Myzhar/RoboDiscovery-F4/README.md

RoboDiscovery-F4
================

Everything you need to create RoboDiscovery-F4
