Myzhar/RoboDiscovery-F4/Firmware/Sonar-Module.jpg

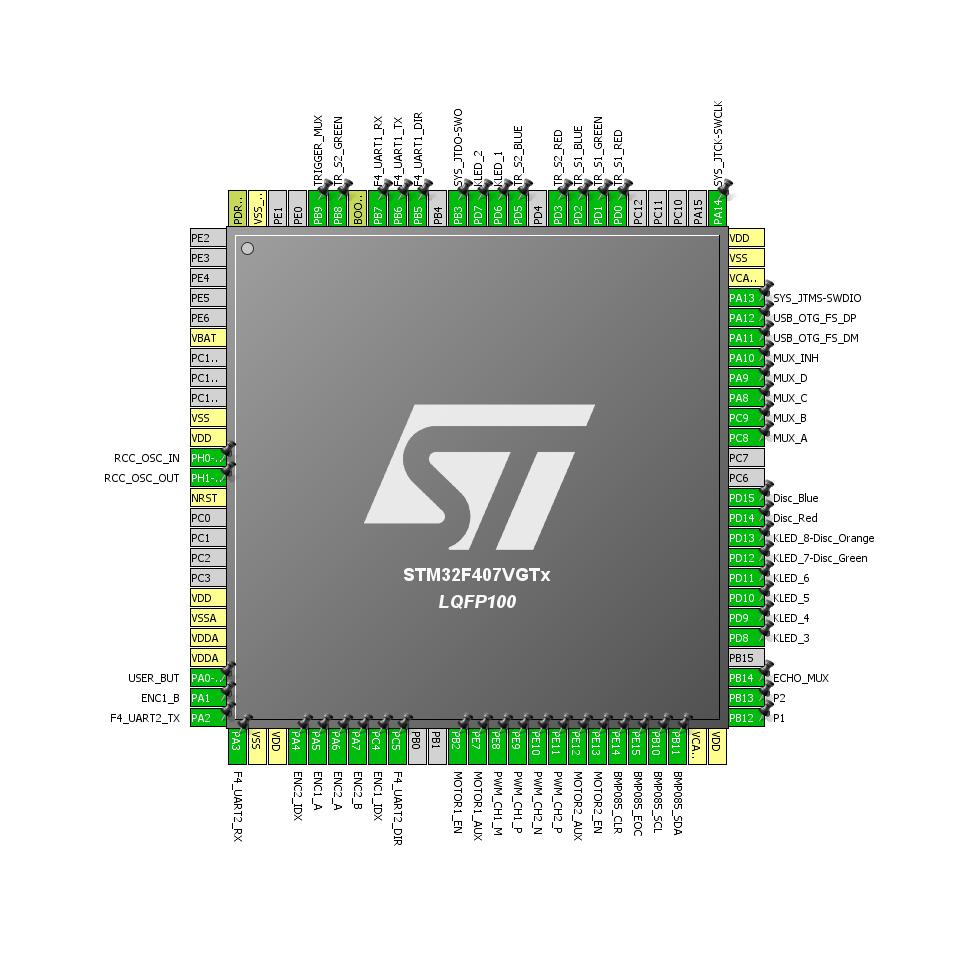
Firmware/Sonar-Module.jpg
