Myzhar/RoboDiscovery-F4/Board/RoboDiscovery-F4_v1.0/RoboDiscovery-F4_V1.0.pdf

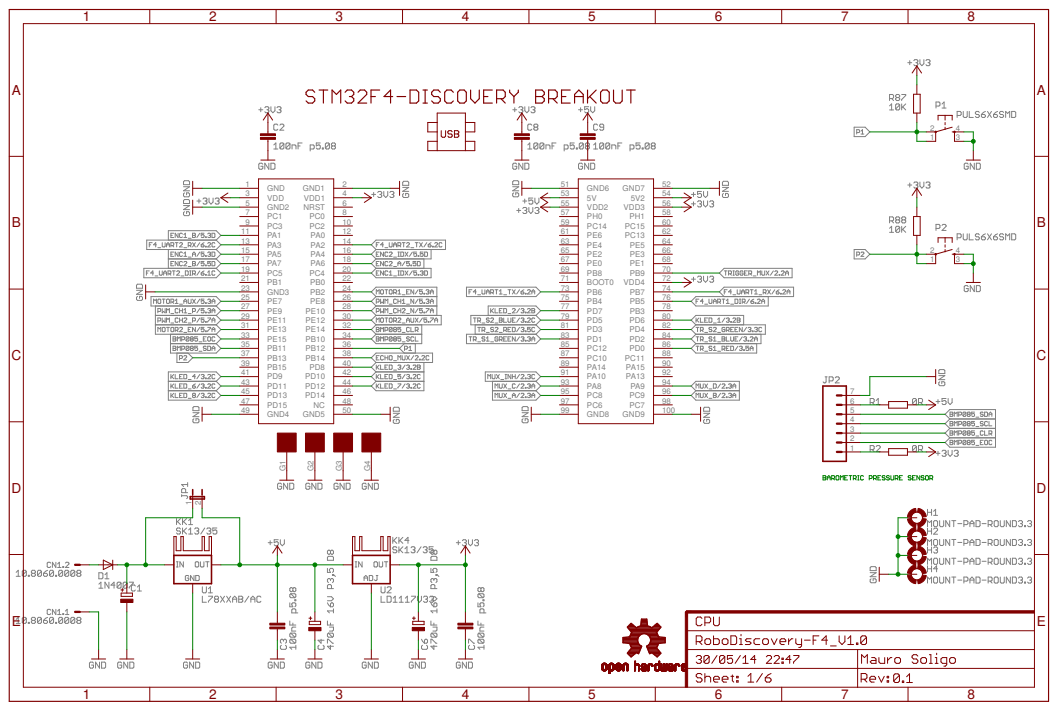
[picture p3: page 1]

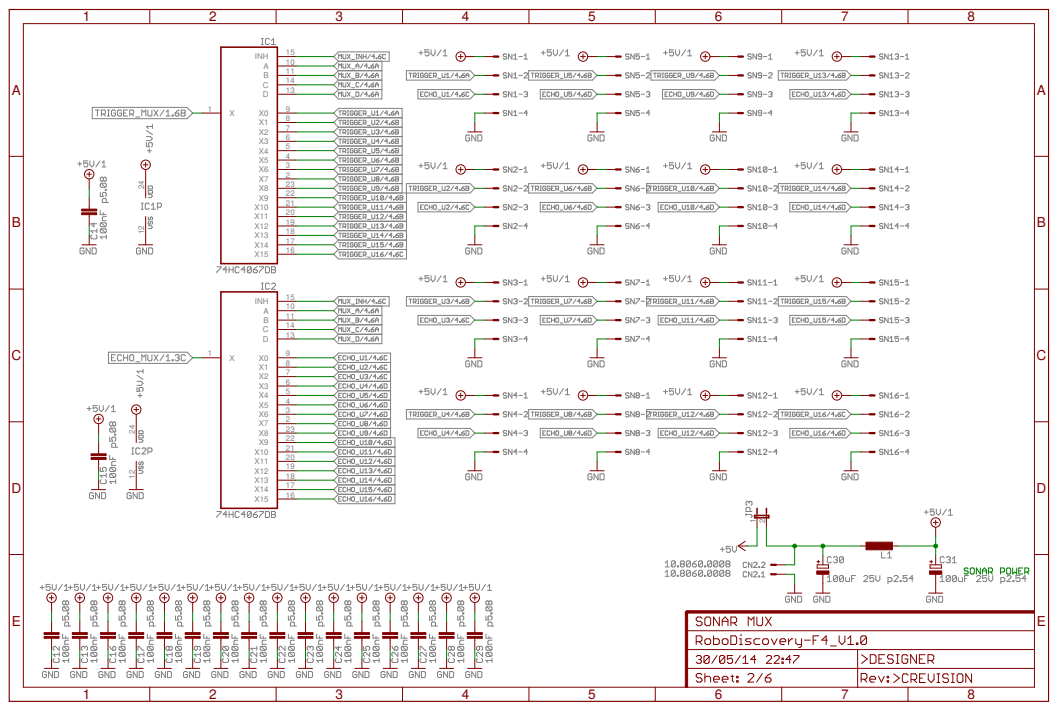
[picture p4: page 2]

12 A 10 B 11 C 14 D 13 X0 9 X1 8 X2 7 X3 6 X4 5 X5 4 X6 3 X7 2 X8 23 X9 22 X10 21 X11 20 X12 19 X13 18 X14 17 X15 16 X 1 INH 15 A 10 B 11 C 14 D 13 X0 9 X1 8 X2 7 X3 6 X4 5 X5 4 X6 3 X7 2 X8 23 X9 22 X10 21 X11 20 X12 19 X13 18 X14 17 X15 16 X 1 INH 15 12 24 12 24 ABCDE 1 2 3 4 5 6 7 8 ABCDE 1 2 3 4 5 6 7 8

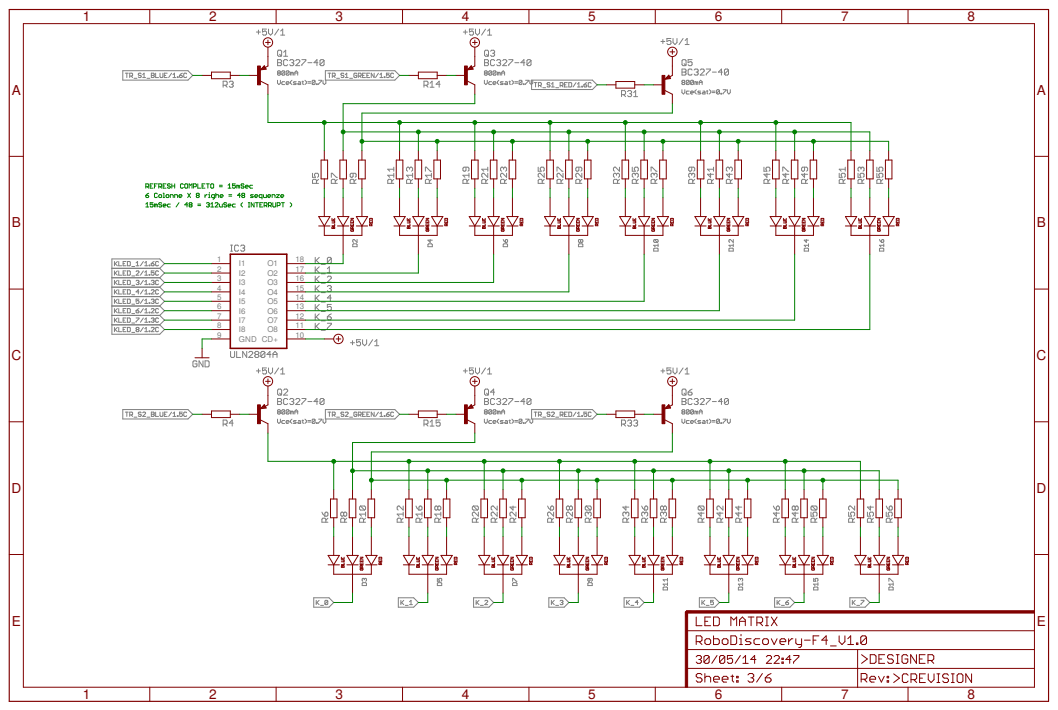
[picture p5: page 3]

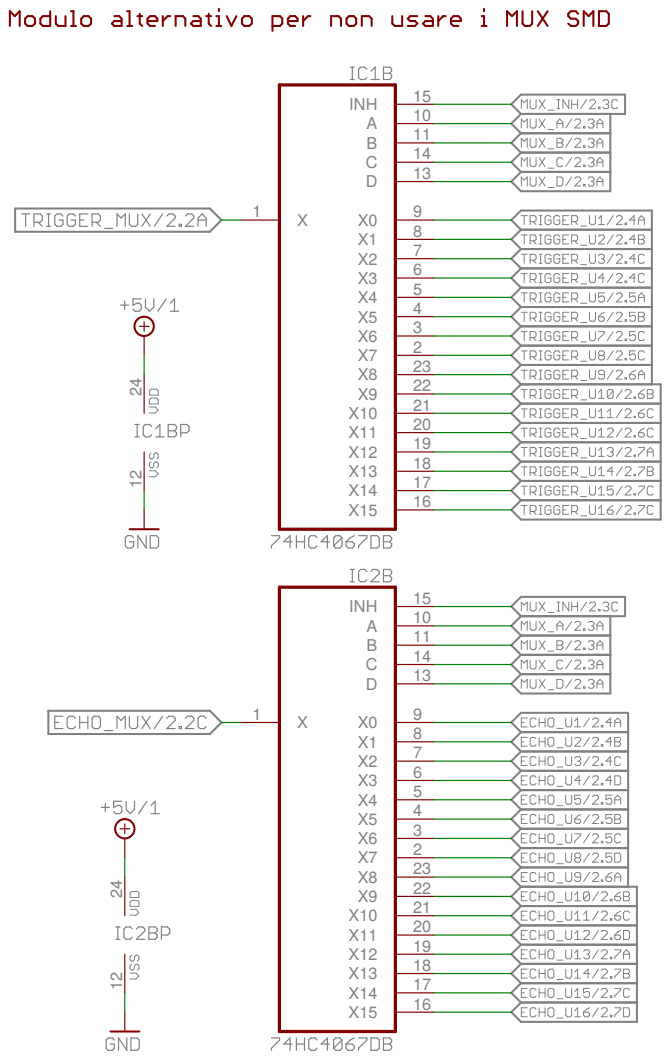
[picture p6: page 4]

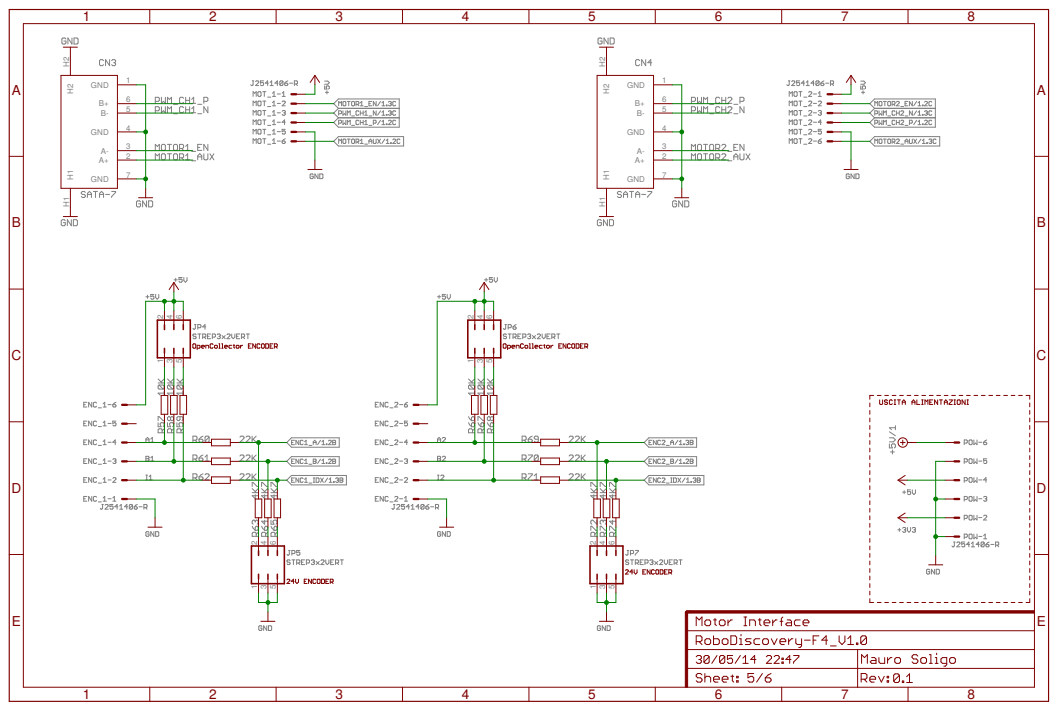
[picture p7: page 5]

1 2 3 4 5 6 1 2 3 4 5 6 H2 H2 B- 5 B+ 6 GND 1 GND 4 A- 3 A+ 2 GND H7 1 H1 H2 H2 B- 5 B+ 6 GND 1 GND 4 A- 3 A+ 2 GND H7 1 H1 1 2 3 4 5 6 1 2 3 4 5 6 ABCDE 1 2 3 4 5 6 7 8 ABCDE 1 2 3 4 5 6 7 8

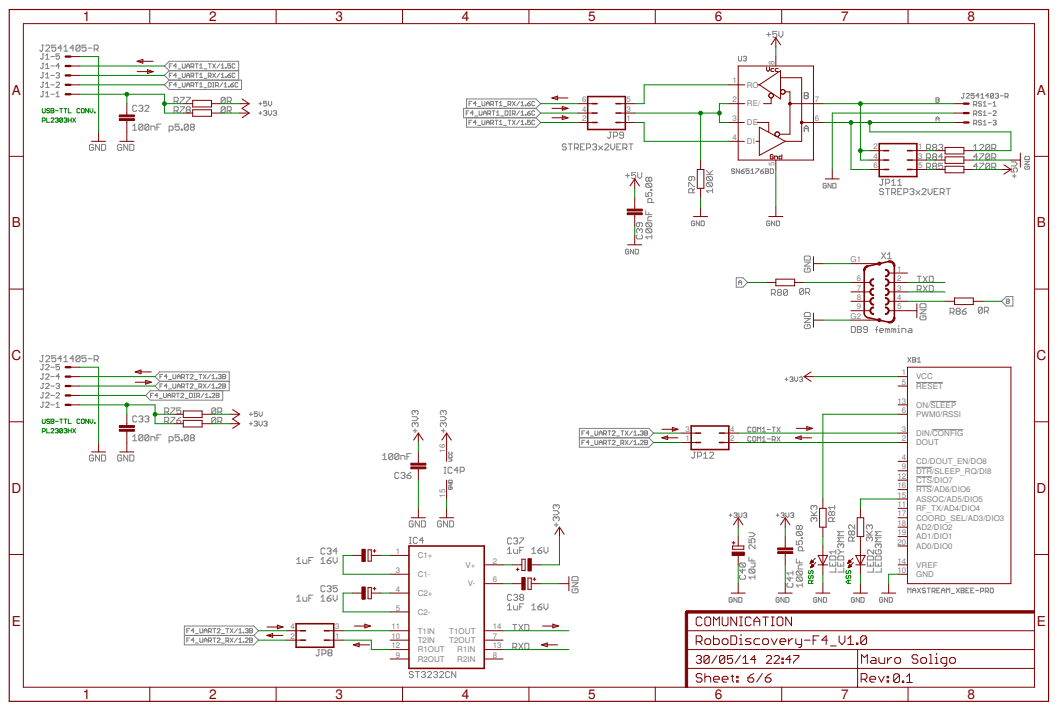
[picture p8: page 6]
