Myzhar/RoboDiscovery-F4/Board/RoboDiscovery-F4_v1.0/RoboDiscovery-F4_V1.0.brd

## EAGLE design Board/RoboDiscovery-F4_v1.0/RoboDiscovery-F4_V1.0.brd (2014-06-24)

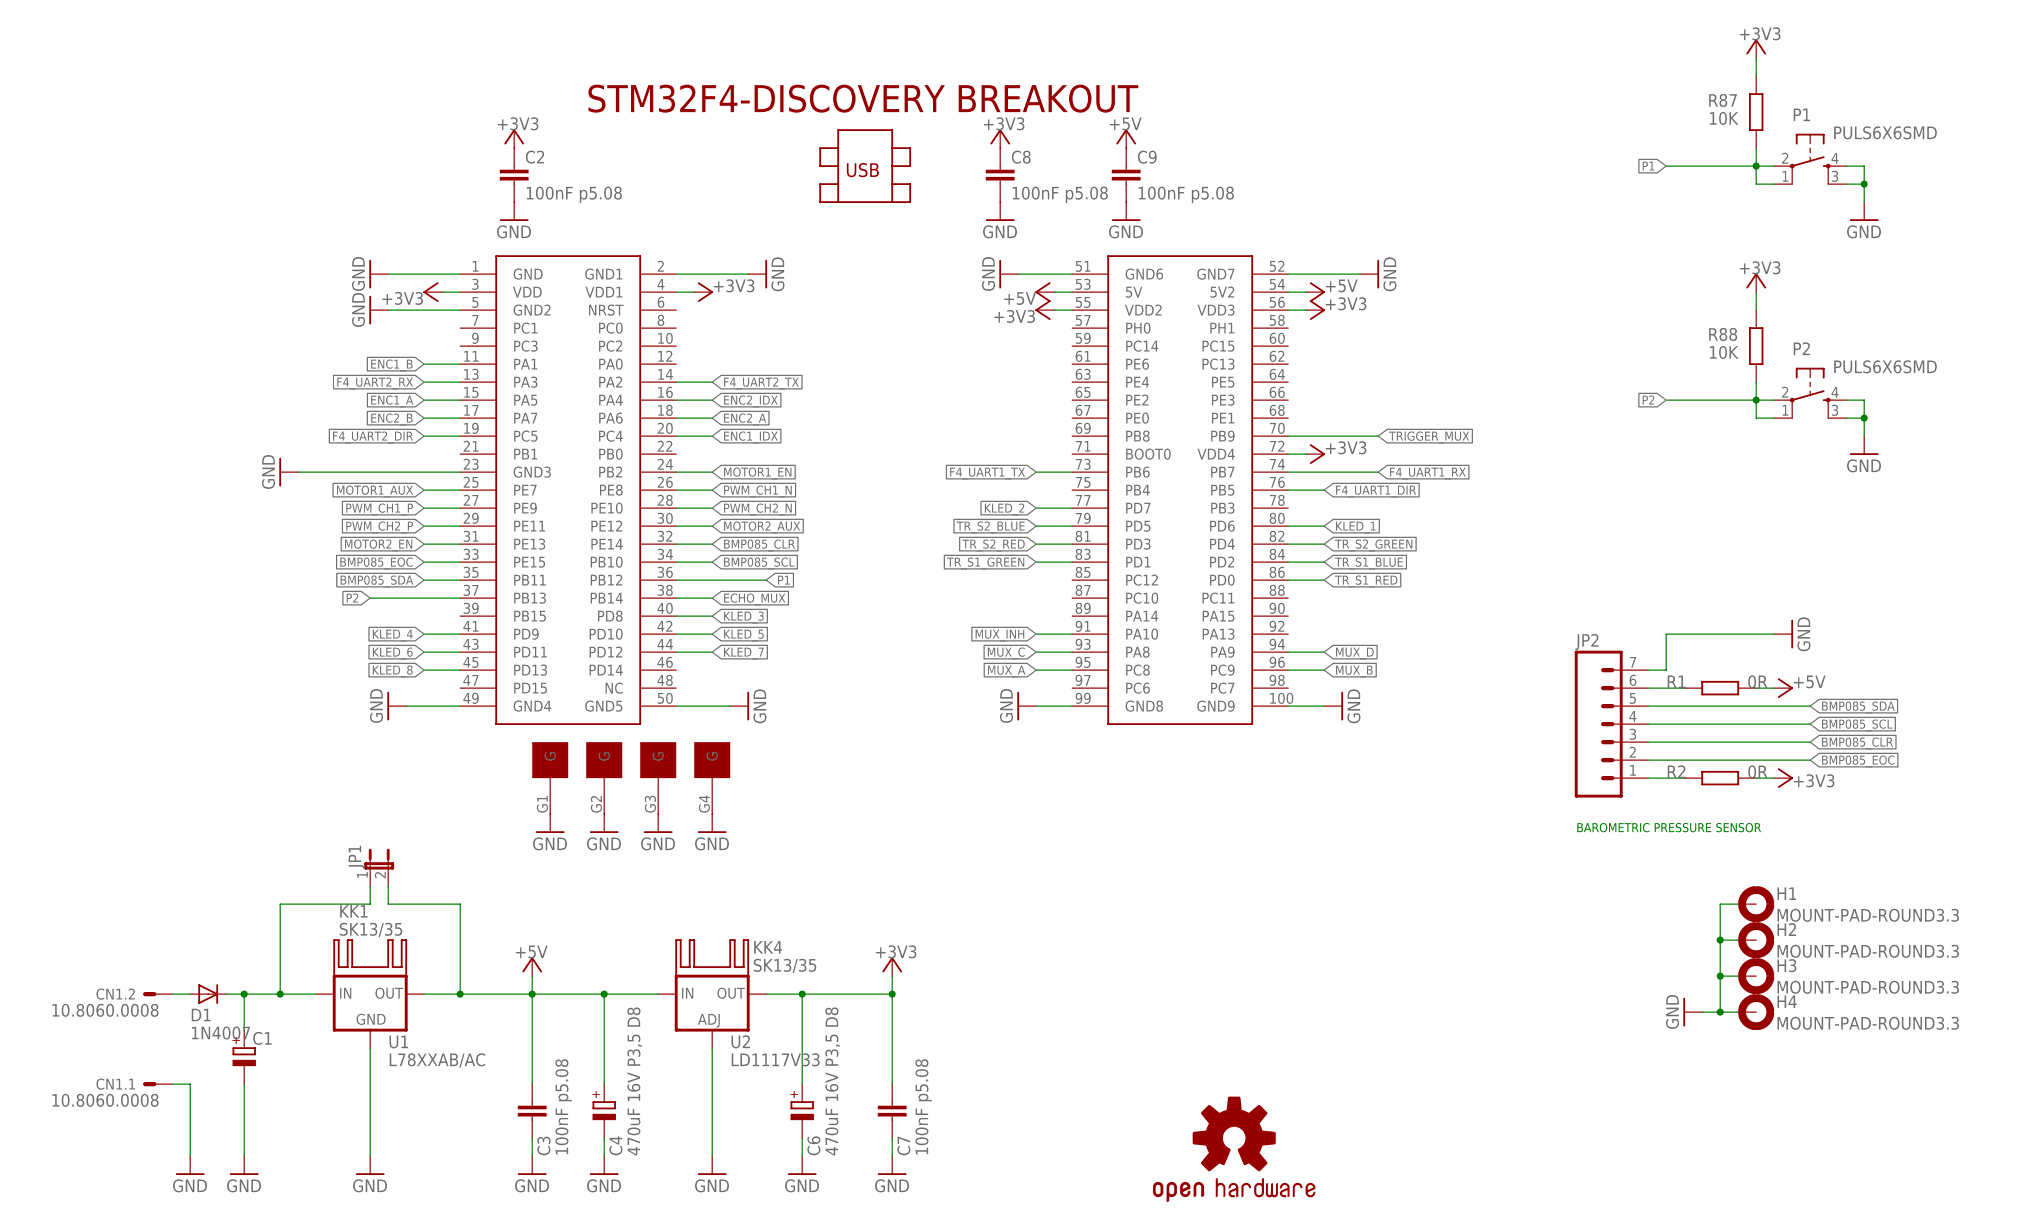
[picture p9: schematic RoboDiscovery-F4_V1.0.sch, sheet 1]

Parts:
C1: CPOL-EUE5-13; E5-13
C2, C3, C7, C8, C9: 100nF p5.08; C050-024X044
C4, C6: 470uF 16V P3,5 D8; E3,5-8
CN1: 10.8060.0008; 300-021-13_2P/5VE
D1: 1N4007; D041-10
DIS1: STM32F4-DISCOVERY
H1, H2, H3, H4: MOUNT-PAD-ROUND3.3; 3,3-PAD
JP1: JP1E; JP1
JP2: M07LONGPADS; 1X07_LONGPADS
KK1, KK4: SK13/35
LOGO1: OSHW-LOGOM; OSHW-LOGO-M
P1, P2: PULS6X6SMD
R1, R2: 0R; 0207/7
R87, R88: 10K; 0207/7
U1: L78XXAB/AC; 78XXL
U2: LD1117V33; 317TL

Connections:
+3V3: C2.1, C6.+, C7.1, C8.1, DIS1.3 (VDD), DIS1.4 (VDD1), DIS1.55 (VDD2), DIS1.56 (VDD3), DIS1.72 (VDD4), R2.1, R87.1, R88.1, U2.2 (OUT); also elsewhere on the board
+5V: C3.1, C4.+, C9.1, DIS1.53 (5V), DIS1.54 (5V2), JP1.2, R1.1, U1.OUT, U2.3 (IN); also elsewhere on the board
BMP085_CLR: DIS1.32 (PE14), JP2.3
BMP085_EOC: DIS1.33 (PE15), JP2.2
BMP085_SCL: DIS1.34 (PB10), JP2.4
BMP085_SDA: DIS1.35 (PB11), JP2.5
ECHO_MUX: DIS1.38 (PB14); also elsewhere on the board
ENC1_A: DIS1.15 (PA5); also elsewhere on the board
ENC1_B: DIS1.11 (PA1); also elsewhere on the board
ENC1_IDX: DIS1.20 (PC4); also elsewhere on the board
ENC2_A: DIS1.18 (PA6); also elsewhere on the board
ENC2_B: DIS1.17 (PA7); also elsewhere on the board
ENC2_IDX: DIS1.16 (PA4); also elsewhere on the board
F4_UART1_DIR: DIS1.76 (PB5); also elsewhere on the board
F4_UART1_RX: DIS1.74 (PB7); also elsewhere on the board
F4_UART1_TX: DIS1.73 (PB6); also elsewhere on the board
F4_UART2_DIR: DIS1.19 (PC5); also elsewhere on the board
F4_UART2_RX: DIS1.13 (PA3); also elsewhere on the board
F4_UART2_TX: DIS1.14 (PA2); also elsewhere on the board
GND: C1.-, C2.2, C3.2, C4.-, C6.-, C7.2, C8.2, C9.2, CN1.1, DIS1.1 (GND), DIS1.2 (GND1), DIS1.5 (GND2), DIS1.23 (GND3), DIS1.49 (GND4), DIS1.50 (GND5), DIS1.51 (GND6), DIS1.52 (GND7), DIS1.99 (GND8), DIS1.100 (GND9), DIS1.G1 (G), DIS1.G2 (G), DIS1.G3 (G), DIS1.G4 (G), H1.B3,3, H2.B3,3, H3.B3,3, H4.B3,3, JP2.7, P1.3 (S1), P1.4 (S), P2.3 (S1), P2.4 (S), U1.GND, U2.1 (ADJ); also elsewhere on the board
KLED_1: DIS1.80 (PD6); also elsewhere on the board
KLED_2: DIS1.77 (PD7); also elsewhere on the board
KLED_3: DIS1.40 (PD8); also elsewhere on the board
KLED_4: DIS1.41 (PD9); also elsewhere on the board
KLED_5: DIS1.42 (PD10); also elsewhere on the board
KLED_6: DIS1.43 (PD11); also elsewhere on the board
KLED_7: DIS1.44 (PD12); also elsewhere on the board
KLED_8: DIS1.45 (PD13); also elsewhere on the board
MOTOR1_AUX: DIS1.25 (PE7); also elsewhere on the board
MOTOR1_EN: DIS1.24 (PB2); also elsewhere on the board
MOTOR2_AUX: DIS1.30 (PE12); also elsewhere on the board
MOTOR2_EN: DIS1.31 (PE13); also elsewhere on the board
MUX_A: DIS1.95 (PC8); also elsewhere on the board
MUX_B: DIS1.96 (PC9); also elsewhere on the board
MUX_C: DIS1.93 (PA8); also elsewhere on the board
MUX_D: DIS1.94 (PA9); also elsewhere on the board
MUX_INH: DIS1.91 (PA10); also elsewhere on the board
unnamed: C1.+, D1.C, JP1.1, U1.IN
unnamed: JP2.6, R1.2
unnamed: JP2.1, R2.2
unnamed: CN1.2, D1.A
P1: DIS1.36 (PB12), P1.1, P1.2, R87.2
P2: DIS1.37 (PB13), P2.1, P2.2, R88.2
PWM_CH1_N: DIS1.26 (PE8); also elsewhere on the board
PWM_CH1_P: DIS1.27 (PE9); also elsewhere on the board
PWM_CH2_N: DIS1.28 (PE10); also elsewhere on the board
PWM_CH2_P: DIS1.29 (PE11); also elsewhere on the board
TRIGGER_MUX: DIS1.70 (PB9); also elsewhere on the board
TR_S1_BLUE: DIS1.84 (PD2); also elsewhere on the board
TR_S1_GREEN: DIS1.83 (PD1); also elsewhere on the board
TR_S1_RED: DIS1.86 (PD0); also elsewhere on the board
TR_S2_BLUE: DIS1.79 (PD5); also elsewhere on the board
TR_S2_GREEN: DIS1.82 (PD4); also elsewhere on the board
TR_S2_RED: DIS1.81 (PD3); also elsewhere on the board

Notes on the sheet:
BAROMETRIC PRESSURE SENSOR

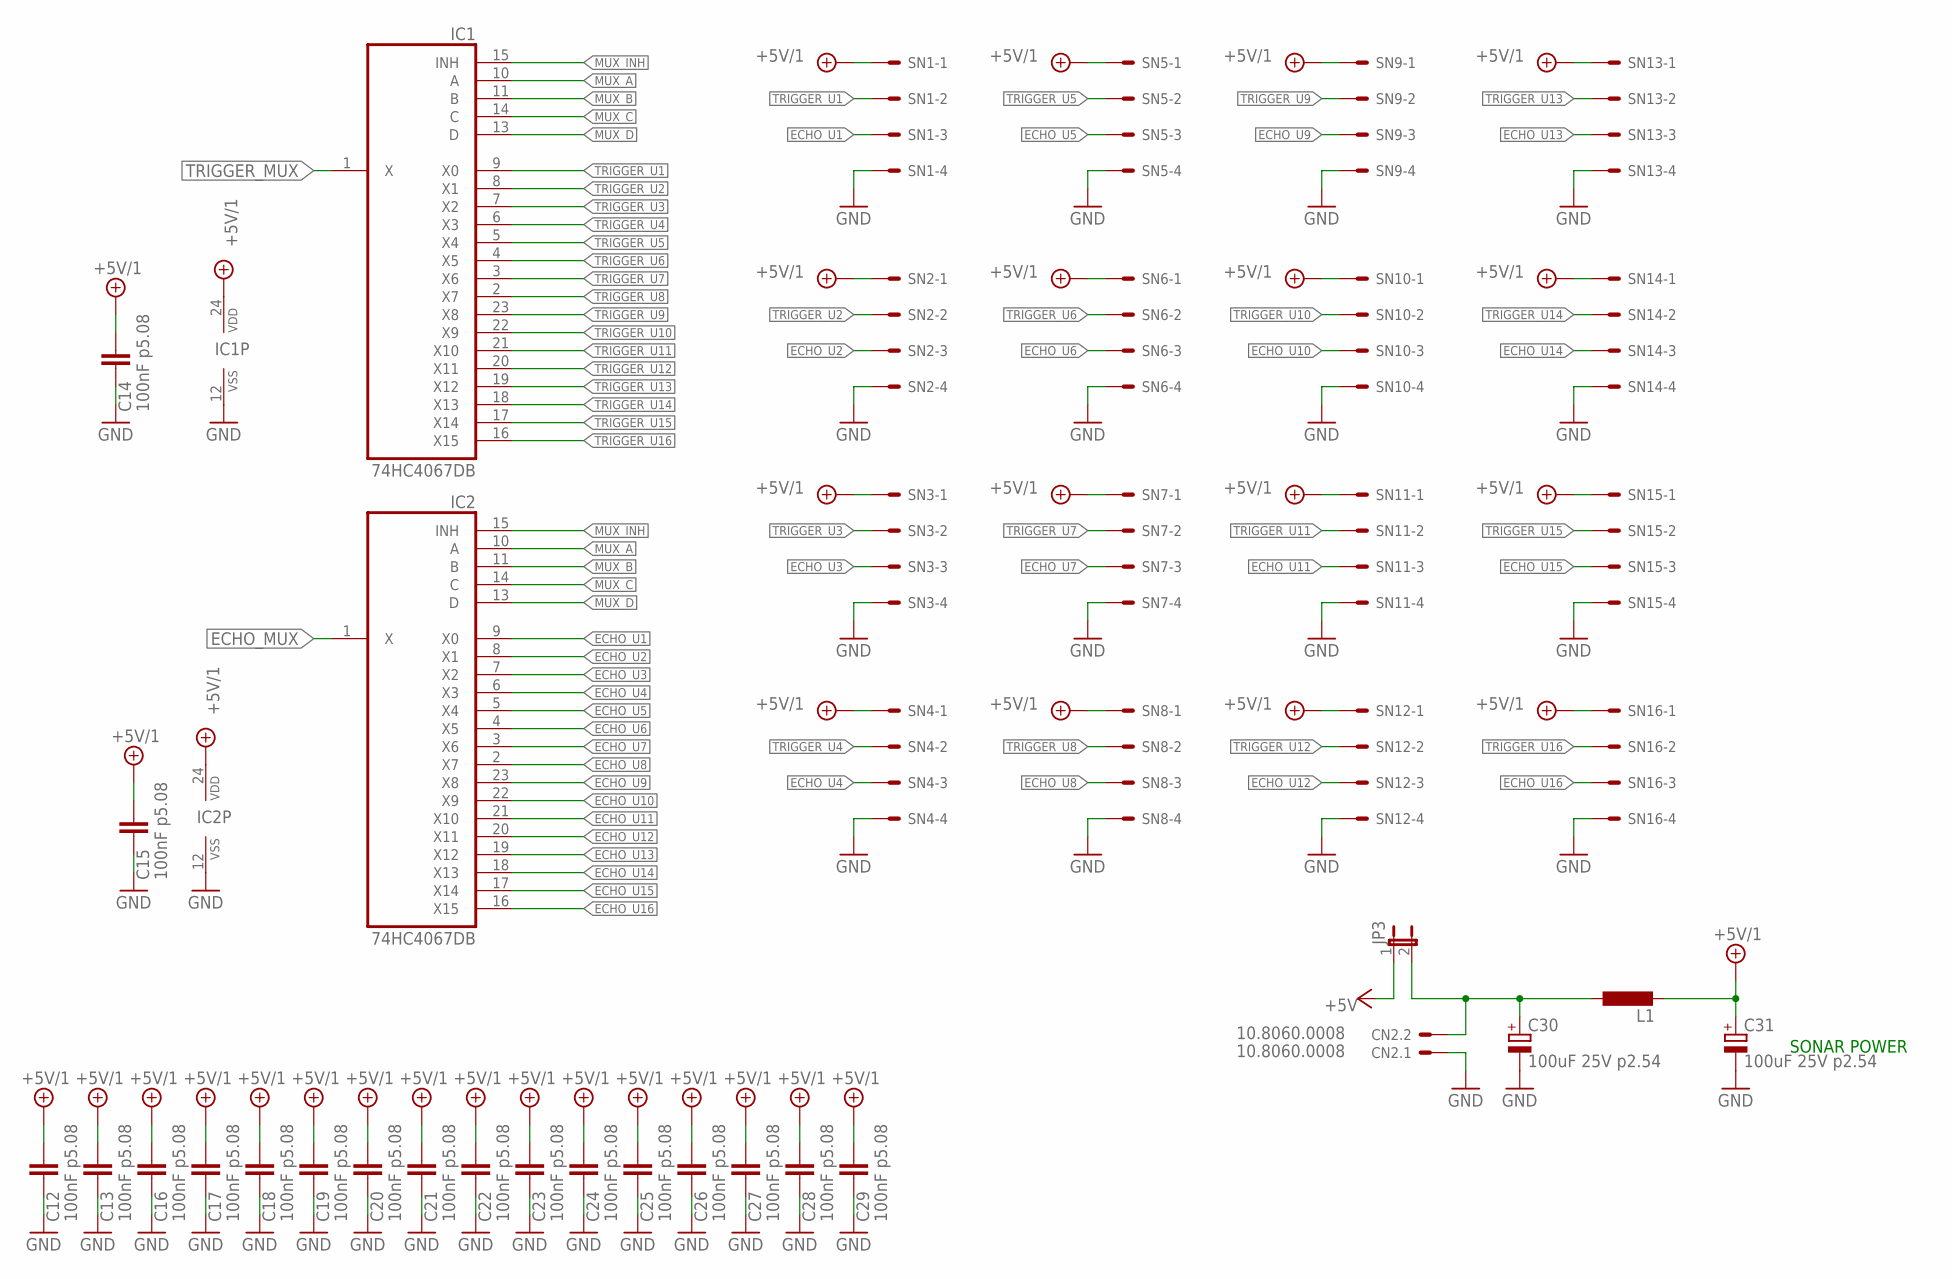
[picture p10: schematic RoboDiscovery-F4_V1.0.sch, sheet 2]

Parts:
C12, C13, C14, C15, C16, C17, C18, C19, C20, C21, C22, C23, C24, C25, C26, C27, C28, C29: 100nF p5.08; C050-024X044
C30, C31: 100uF 25V p2.54; E2,5-6
CN2: 10.8060.0008; 300-021-13_2P/5VE
IC1, IC2: 74HC4067DB; SO24W
JP3: JP1E; JP1
L1: L-EU2200-12.7; 2200-12.7
SN1, SN2, SN3, SN4, SN5, SN6, SN7, SN8, SN9, SN10, SN11, SN12, SN13, SN14, SN15, SN16: 22-27-2041-04; 6410-04

Connections:
+5V: JP3.1; also elsewhere on the board
+5V/1: C12.1, C13.1, C14.1, C15.1, C16.1, C17.1, C18.1, C19.1, C20.1, C21.1, C22.1, C23.1, C24.1, C25.1, C26.1, C27.1, C28.1, C29.1, C31.+, IC1.24 (VDD), IC2.24 (VDD), L1.2, SN1.1, SN2.1, SN3.1, SN4.1, SN5.1, SN6.1, SN7.1, SN8.1, SN9.1, SN10.1, SN11.1, SN12.1, SN13.1, SN14.1, SN15.1, SN16.1; also elsewhere on the board
ECHO_MUX: IC2.1 (X); also elsewhere on the board
ECHO_U1: IC2.9 (X0), SN1.3; also elsewhere on the board
ECHO_U2: IC2.8 (X1), SN2.3; also elsewhere on the board
ECHO_U3: IC2.7 (X2), SN3.3; also elsewhere on the board
ECHO_U4: IC2.6 (X3), SN4.3; also elsewhere on the board
ECHO_U5: IC2.5 (X4), SN5.3; also elsewhere on the board
ECHO_U6: IC2.4 (X5), SN6.3; also elsewhere on the board
ECHO_U7: IC2.3 (X6), SN7.3; also elsewhere on the board
ECHO_U8: IC2.2 (X7), SN8.3; also elsewhere on the board
ECHO_U9: IC2.23 (X8), SN9.3; also elsewhere on the board
ECHO_U10: IC2.22 (X9), SN10.3; also elsewhere on the board
ECHO_U11: IC2.21 (X10), SN11.3; also elsewhere on the board
ECHO_U12: IC2.20 (X11), SN12.3; also elsewhere on the board
ECHO_U13: IC2.19 (X12), SN13.3; also elsewhere on the board
ECHO_U14: IC2.18 (X13), SN14.3; also elsewhere on the board
ECHO_U15: IC2.17 (X14), SN15.3; also elsewhere on the board
ECHO_U16: IC2.16 (X15), SN16.3; also elsewhere on the board
GND: C12.2, C13.2, C14.2, C15.2, C16.2, C17.2, C18.2, C19.2, C20.2, C21.2, C22.2, C23.2, C24.2, C25.2, C26.2, C27.2, C28.2, C29.2, C30.-, C31.-, CN2.1, IC1.12 (VSS), IC2.12 (VSS), SN1.4, SN2.4, SN3.4, SN4.4, SN5.4, SN6.4, SN7.4, SN8.4, SN9.4, SN10.4, SN11.4, SN12.4, SN13.4, SN14.4, SN15.4, SN16.4; also elsewhere on the board
MUX_A: IC1.10 (A), IC2.10 (A); also elsewhere on the board
MUX_B: IC1.11 (B), IC2.11 (B); also elsewhere on the board
MUX_C: IC1.14 (C), IC2.14 (C); also elsewhere on the board
MUX_D: IC1.13 (D), IC2.13 (D); also elsewhere on the board
MUX_INH: IC1.15 (INH), IC2.15 (INH); also elsewhere on the board
unnamed: C30.+, CN2.2, JP3.2, L1.1
TRIGGER_MUX: IC1.1 (X); also elsewhere on the board
TRIGGER_U1: IC1.9 (X0), SN1.2; also elsewhere on the board
TRIGGER_U2: IC1.8 (X1), SN2.2; also elsewhere on the board
TRIGGER_U3: IC1.7 (X2), SN3.2; also elsewhere on the board
TRIGGER_U4: IC1.6 (X3), SN4.2; also elsewhere on the board
TRIGGER_U5: IC1.5 (X4), SN5.2; also elsewhere on the board
TRIGGER_U6: IC1.4 (X5), SN6.2; also elsewhere on the board
TRIGGER_U7: IC1.3 (X6), SN7.2; also elsewhere on the board
TRIGGER_U8: IC1.2 (X7), SN8.2; also elsewhere on the board
TRIGGER_U9: IC1.23 (X8), SN9.2; also elsewhere on the board
TRIGGER_U10: IC1.22 (X9), SN10.2; also elsewhere on the board
TRIGGER_U11: IC1.21 (X10), SN11.2; also elsewhere on the board
TRIGGER_U12: IC1.20 (X11), SN12.2; also elsewhere on the board
TRIGGER_U13: IC1.19 (X12), SN13.2; also elsewhere on the board
TRIGGER_U14: IC1.18 (X13), SN14.2; also elsewhere on the board
TRIGGER_U15: IC1.17 (X14), SN15.2; also elsewhere on the board
TRIGGER_U16: IC1.16 (X15), SN16.2; also elsewhere on the board

Notes on the sheet:
SONAR POWER

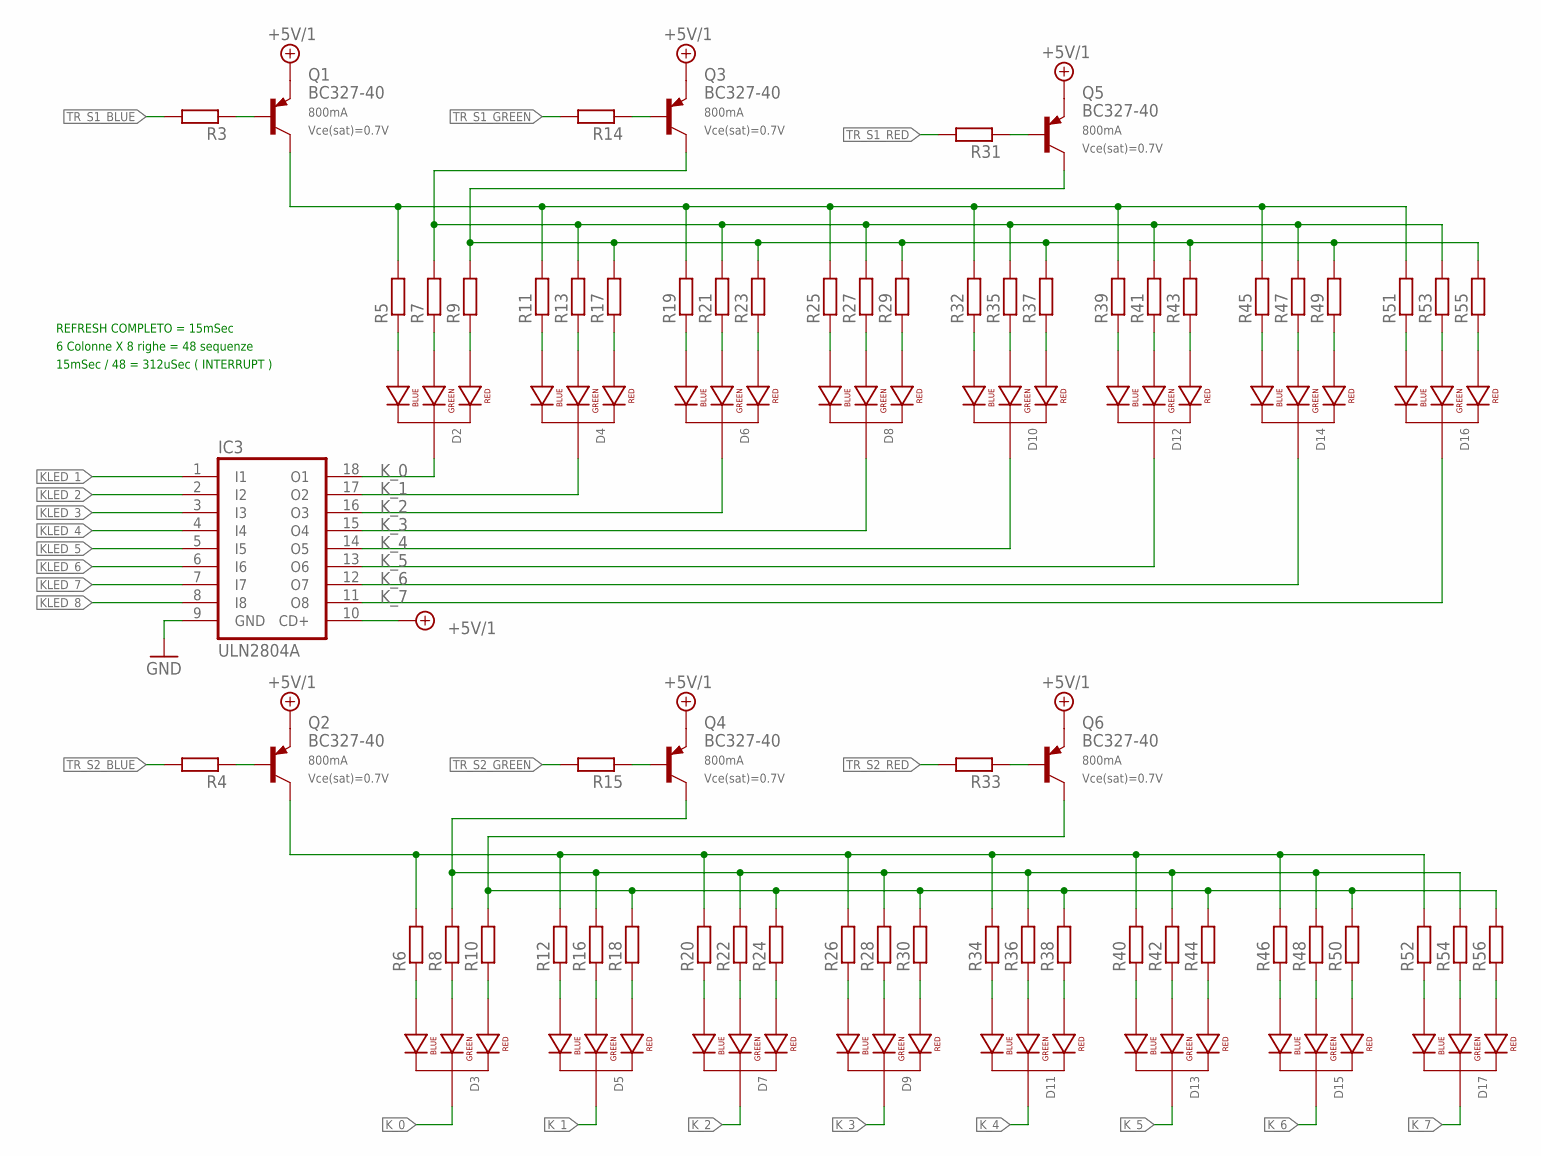
[picture p11: schematic RoboDiscovery-F4_V1.0.sch, sheet 3]

Parts:
D2, D3, D4, D5, D6, D7, D8, D9, D10, D11, D12, D13, D14, D15, D16, D17: LED-RGB-CC-THRUDIFFUSE; LED-RGB-THRU
IC3: ULN2804A; DIL18
Q1, Q2, Q3, Q4, Q5, Q6: BC327-40; TO92-EBC
R3, R4, R5, R6, R7, R8, R9, R10, R11, R12, R13, R14, R15, R16, R17, R18, R19, R20, R21, R22, R23, R24, R25, R26, R27, R28, R29, R30, R31, R32, R33, R34, R35, R36, R37, R38, R39, R40, R41, R42, R43, R44, R45, R46, R47, R48, R49, R50, R51, R52, R53, R54, R55, R56: R-EU_0207/7; 0207/7

Connections:
+5V/1: IC3.10 (CD+), Q1.E, Q2.E, Q3.E, Q4.E, Q5.E, Q6.E; also elsewhere on the board
GND: IC3.9 (GND); also elsewhere on the board
KLED_1: IC3.1 (I1); also elsewhere on the board
KLED_2: IC3.2 (I2); also elsewhere on the board
KLED_3: IC3.3 (I3); also elsewhere on the board
KLED_4: IC3.4 (I4); also elsewhere on the board
KLED_5: IC3.5 (I5); also elsewhere on the board
KLED_6: IC3.6 (I6); also elsewhere on the board
KLED_7: IC3.7 (I7); also elsewhere on the board
KLED_8: IC3.8 (I8); also elsewhere on the board
K_0: D2.2 (CATHODE), D3.2 (CATHODE), IC3.18 (O1)
K_1: D4.2 (CATHODE), D5.2 (CATHODE), IC3.17 (O2)
K_2: D6.2 (CATHODE), D7.2 (CATHODE), IC3.16 (O3)
K_3: D8.2 (CATHODE), D9.2 (CATHODE), IC3.15 (O4)
K_4: D10.2 (CATHODE), D11.2 (CATHODE), IC3.14 (O5)
K_5: D12.2 (CATHODE), D13.2 (CATHODE), IC3.13 (O6)
K_6: D14.2 (CATHODE), D15.2 (CATHODE), IC3.12 (O7)
K_7: D16.2 (CATHODE), D17.2 (CATHODE), IC3.11 (O8)
unnamed: Q1.C, R5.2, R11.2, R19.2, R25.2, R32.2, R39.2, R45.2, R51.2
unnamed: Q3.C, R7.2, R13.2, R21.2, R27.2, R35.2, R41.2, R47.2, R53.2
unnamed: Q5.C, R9.2, R17.2, R23.2, R29.2, R37.2, R43.2, R49.2, R55.2
unnamed: D2.4 (BLUE_CATHODE), R5.1
unnamed: D2.3 (GREEN_CATHODE), R7.1
unnamed: D2.1 (RED_CATHODE), R9.1
unnamed: D4.4 (BLUE_CATHODE), R11.1
unnamed: D4.3 (GREEN_CATHODE), R13.1
unnamed: D4.1 (RED_CATHODE), R17.1
unnamed: D6.4 (BLUE_CATHODE), R19.1
unnamed: D6.3 (GREEN_CATHODE), R21.1
unnamed: D6.1 (RED_CATHODE), R23.1
unnamed: D8.4 (BLUE_CATHODE), R25.1
unnamed: D8.3 (GREEN_CATHODE), R27.1
unnamed: D8.1 (RED_CATHODE), R29.1
unnamed: D10.4 (BLUE_CATHODE), R32.1
unnamed: D10.3 (GREEN_CATHODE), R35.1
unnamed: D10.1 (RED_CATHODE), R37.1
unnamed: D12.4 (BLUE_CATHODE), R39.1
unnamed: D12.3 (GREEN_CATHODE), R41.1
unnamed: D12.1 (RED_CATHODE), R43.1
unnamed: D14.4 (BLUE_CATHODE), R45.1
unnamed: D14.3 (GREEN_CATHODE), R47.1
unnamed: D14.1 (RED_CATHODE), R49.1
unnamed: D16.4 (BLUE_CATHODE), R51.1
unnamed: D16.3 (GREEN_CATHODE), R53.1
unnamed: D16.1 (RED_CATHODE), R55.1
unnamed: Q2.C, R6.2, R12.2, R20.2, R26.2, R34.2, R40.2, R46.2, R52.2
unnamed: Q4.C, R8.2, R16.2, R22.2, R28.2, R36.2, R42.2, R48.2, R54.2
unnamed: Q6.C, R10.2, R18.2, R24.2, R30.2, R38.2, R44.2, R50.2, R56.2
unnamed: D3.4 (BLUE_CATHODE), R6.1
unnamed: D3.3 (GREEN_CATHODE), R8.1
unnamed: D3.1 (RED_CATHODE), R10.1
unnamed: D5.4 (BLUE_CATHODE), R12.1
unnamed: D5.3 (GREEN_CATHODE), R16.1
unnamed: D5.1 (RED_CATHODE), R18.1
unnamed: D7.4 (BLUE_CATHODE), R20.1
unnamed: D7.3 (GREEN_CATHODE), R22.1
unnamed: D7.1 (RED_CATHODE), R24.1
unnamed: D9.4 (BLUE_CATHODE), R26.1
unnamed: D9.3 (GREEN_CATHODE), R28.1
unnamed: D9.1 (RED_CATHODE), R30.1
unnamed: D11.4 (BLUE_CATHODE), R34.1
unnamed: D11.3 (GREEN_CATHODE), R36.1
unnamed: D11.1 (RED_CATHODE), R38.1
unnamed: D13.4 (BLUE_CATHODE), R40.1
unnamed: D13.3 (GREEN_CATHODE), R42.1
unnamed: D13.1 (RED_CATHODE), R44.1
unnamed: D15.4 (BLUE_CATHODE), R46.1
unnamed: D15.3 (GREEN_CATHODE), R48.1
unnamed: D15.1 (RED_CATHODE), R50.1
unnamed: D17.4 (BLUE_CATHODE), R52.1
unnamed: D17.3 (GREEN_CATHODE), R54.1
unnamed: D17.1 (RED_CATHODE), R56.1
unnamed: Q1.B, R3.1
unnamed: Q3.B, R14.1
unnamed: Q5.B, R31.1
unnamed: Q2.B, R4.1
unnamed: Q4.B, R15.1
unnamed: Q6.B, R33.1
TR_S1_BLUE: R3.2; also elsewhere on the board
TR_S1_GREEN: R14.2; also elsewhere on the board
TR_S1_RED: R31.2; also elsewhere on the board
TR_S2_BLUE: R4.2; also elsewhere on the board
TR_S2_GREEN: R15.2; also elsewhere on the board
TR_S2_RED: R33.2; also elsewhere on the board

Notes on the sheet:
REFRESH COMPLETO = 15mSec
6 Colonne X 8 righe = 48 sequenze
15mSec / 48 = 312uSec ( INTERRUPT )

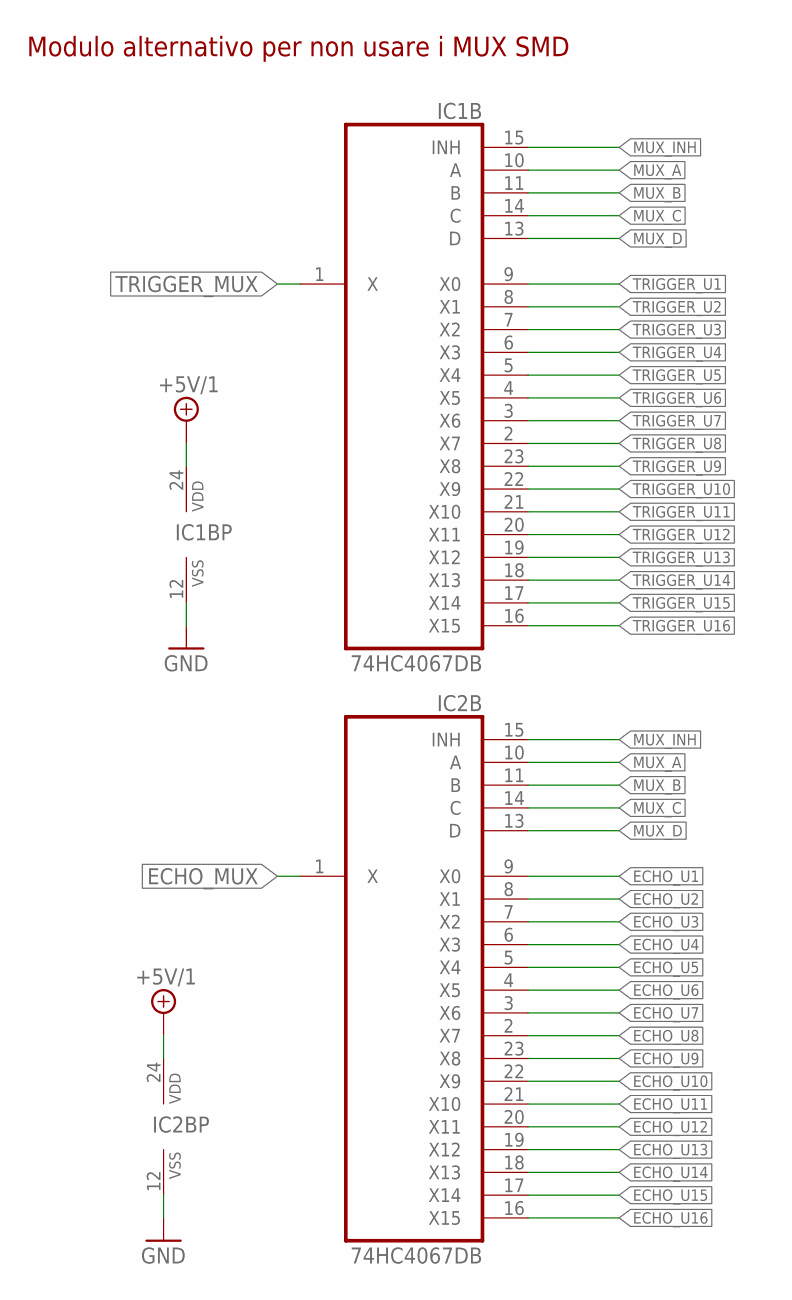
[picture p12: schematic RoboDiscovery-F4_V1.0.sch, sheet 4]

Parts:
IC1B, IC2B: 74HC4067DB; DIL24-6

Connections:
+5V/1: IC1B.24 (VDD), IC2B.24 (VDD); also elsewhere on the board
ECHO_MUX: IC2B.1 (X); also elsewhere on the board
ECHO_U1: IC2B.9 (X0); also elsewhere on the board
ECHO_U2: IC2B.8 (X1); also elsewhere on the board
ECHO_U3: IC2B.7 (X2); also elsewhere on the board
ECHO_U4: IC2B.6 (X3); also elsewhere on the board
ECHO_U5: IC2B.5 (X4); also elsewhere on the board
ECHO_U6: IC2B.4 (X5); also elsewhere on the board
ECHO_U7: IC2B.3 (X6); also elsewhere on the board
ECHO_U8: IC2B.2 (X7); also elsewhere on the board
ECHO_U9: IC2B.23 (X8); also elsewhere on the board
ECHO_U10: IC2B.22 (X9); also elsewhere on the board
ECHO_U11: IC2B.21 (X10); also elsewhere on the board
ECHO_U12: IC2B.20 (X11); also elsewhere on the board
ECHO_U13: IC2B.19 (X12); also elsewhere on the board
ECHO_U14: IC2B.18 (X13); also elsewhere on the board
ECHO_U15: IC2B.17 (X14); also elsewhere on the board
ECHO_U16: IC2B.16 (X15); also elsewhere on the board
GND: IC1B.12 (VSS), IC2B.12 (VSS); also elsewhere on the board
MUX_A: IC1B.10 (A), IC2B.10 (A); also elsewhere on the board
MUX_B: IC1B.11 (B), IC2B.11 (B); also elsewhere on the board
MUX_C: IC1B.14 (C), IC2B.14 (C); also elsewhere on the board
MUX_D: IC1B.13 (D), IC2B.13 (D); also elsewhere on the board
MUX_INH: IC1B.15 (INH), IC2B.15 (INH); also elsewhere on the board
TRIGGER_MUX: IC1B.1 (X); also elsewhere on the board
TRIGGER_U1: IC1B.9 (X0); also elsewhere on the board
TRIGGER_U2: IC1B.8 (X1); also elsewhere on the board
TRIGGER_U3: IC1B.7 (X2); also elsewhere on the board
TRIGGER_U4: IC1B.6 (X3); also elsewhere on the board
TRIGGER_U5: IC1B.5 (X4); also elsewhere on the board
TRIGGER_U6: IC1B.4 (X5); also elsewhere on the board
TRIGGER_U7: IC1B.3 (X6); also elsewhere on the board
TRIGGER_U8: IC1B.2 (X7); also elsewhere on the board
TRIGGER_U9: IC1B.23 (X8); also elsewhere on the board
TRIGGER_U10: IC1B.22 (X9); also elsewhere on the board
TRIGGER_U11: IC1B.21 (X10); also elsewhere on the board
TRIGGER_U12: IC1B.20 (X11); also elsewhere on the board
TRIGGER_U13: IC1B.19 (X12); also elsewhere on the board
TRIGGER_U14: IC1B.18 (X13); also elsewhere on the board
TRIGGER_U15: IC1B.17 (X14); also elsewhere on the board
TRIGGER_U16: IC1B.16 (X15); also elsewhere on the board

Notes on the sheet:
Modulo alternativo per non usare i MUX SMD

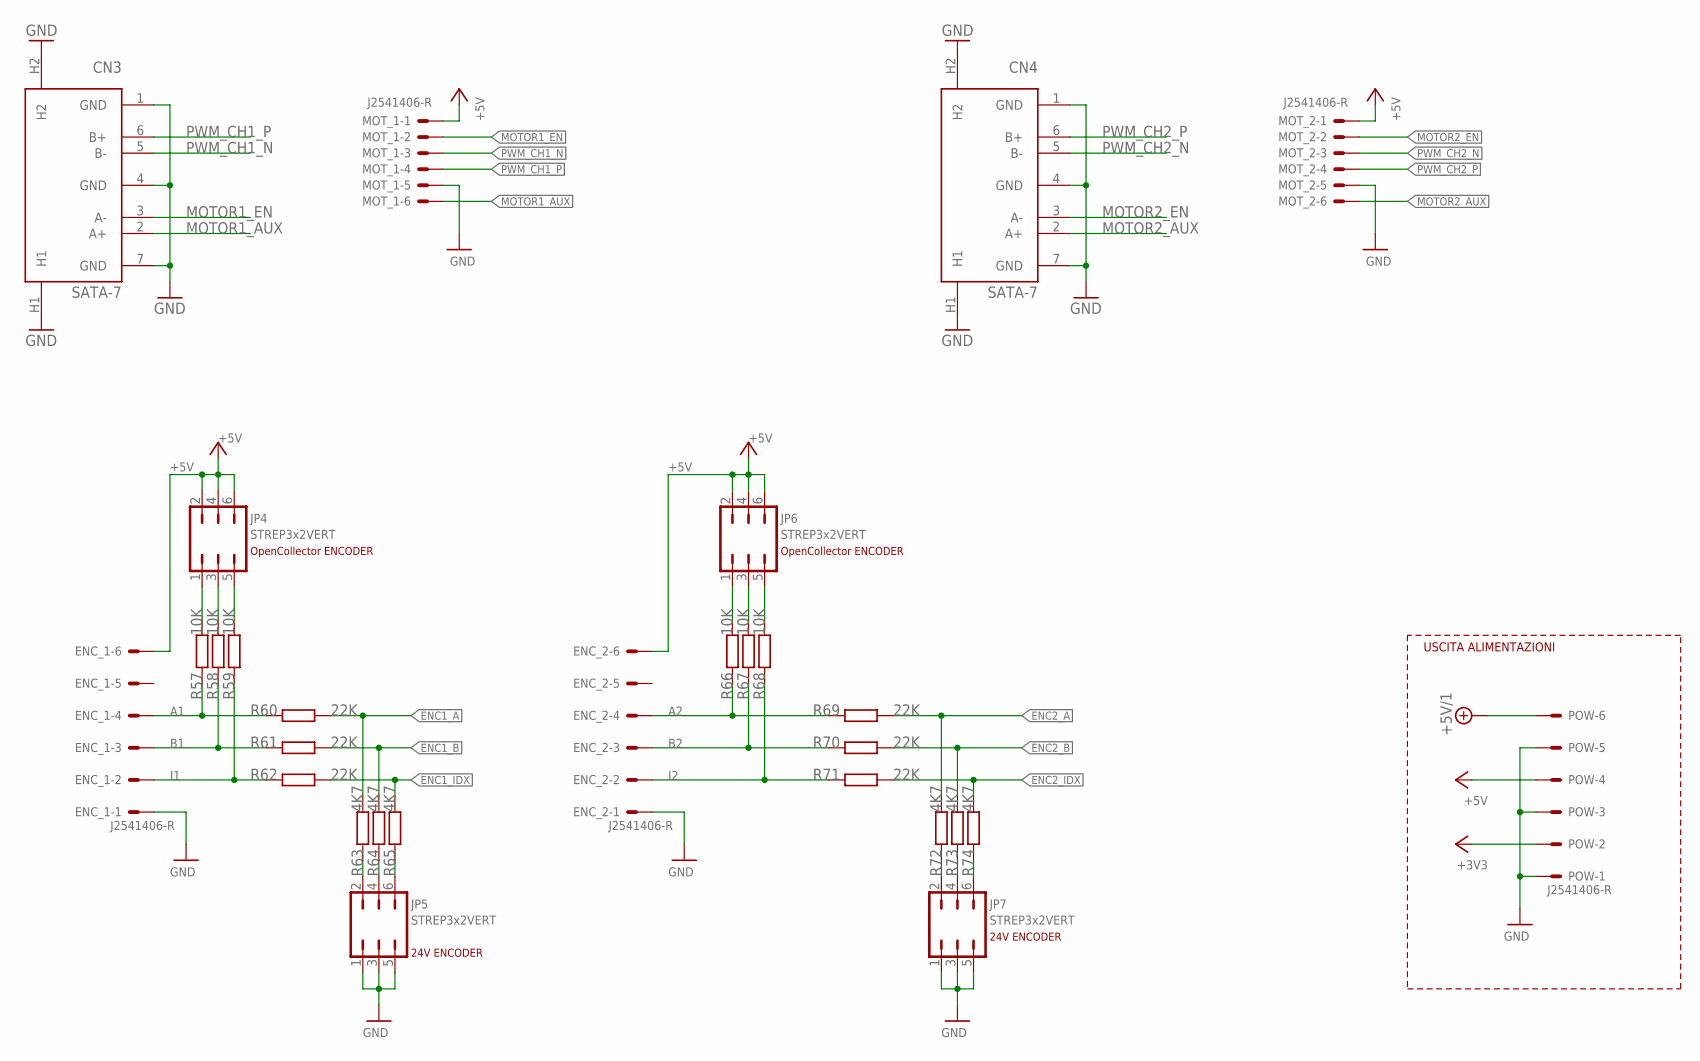
[picture p13: schematic RoboDiscovery-F4_V1.0.sch, sheet 5]

Parts:
CN3, CN4: SATA-7; SATA-5607-5102-SH
ENC_1, ENC_2: J2541406-R; 6410-06
JP4, JP5, JP6, JP7: STREP3x2VERT; JP3Q
MOT_1, MOT_2: J2541406-R; 6410-06
POW: J2541406-R; 6410-06
R57, R58, R59, R66, R67, R68: 10K; 0207/7
R60, R61, R62, R69, R70, R71: 22K; 0207/7
R63, R64, R65, R72, R73, R74: 4K7; 0207/7

Connections:
+3V3: POW.2; also elsewhere on the board
+5V: ENC_1.6, ENC_2.6, JP4.2, JP4.4, JP4.6, JP6.2, JP6.4, JP6.6, MOT_1.1, MOT_2.1, POW.4; also elsewhere on the board
+5V/1: POW.6; also elsewhere on the board
A1: ENC_1.4, R57.1, R60.2
A2: ENC_2.4, R66.1, R69.2
B1: ENC_1.3, R58.1, R61.2
B2: ENC_2.3, R67.1, R70.2
ENC1_A: R60.1, R63.2; also elsewhere on the board
ENC1_B: R61.1, R64.2; also elsewhere on the board
ENC1_IDX: R62.1, R65.2; also elsewhere on the board
ENC2_A: R69.1, R72.2; also elsewhere on the board
ENC2_B: R70.1, R73.2; also elsewhere on the board
ENC2_IDX: R71.1, R74.2; also elsewhere on the board
GND: CN3.1 (GND), CN3.4 (GND), CN3.7 (GND), CN3.H1, CN3.H2, CN4.1 (GND), CN4.4 (GND), CN4.7 (GND), CN4.H1, CN4.H2, ENC_1.1, ENC_2.1, JP5.1, JP5.3, JP5.5, JP7.1, JP7.3, JP7.5, MOT_1.5, MOT_2.5, POW.1, POW.3, POW.5; also elsewhere on the board
I1: ENC_1.2, R59.1, R62.2
I2: ENC_2.2, R68.1, R71.2
MOTOR1_AUX: CN3.2 (A+), MOT_1.6; also elsewhere on the board
MOTOR1_EN: CN3.3 (A-), MOT_1.2; also elsewhere on the board
MOTOR2_AUX: CN4.2 (A+), MOT_2.6; also elsewhere on the board
MOTOR2_EN: CN4.3 (A-), MOT_2.2; also elsewhere on the board
unnamed: JP6.3, R67.2
unnamed: JP6.5, R68.2
unnamed: JP6.1, R66.2
unnamed: JP4.3, R58.2
unnamed: JP4.5, R59.2
unnamed: JP4.1, R57.2
unnamed: JP5.2, R63.1
unnamed: JP5.4, R64.1
unnamed: JP5.6, R65.1
unnamed: JP7.2, R72.1
unnamed: JP7.4, R73.1
unnamed: JP7.6, R74.1
PWM_CH1_N: CN3.5 (B-), MOT_1.3; also elsewhere on the board
PWM_CH1_P: CN3.6 (B+), MOT_1.4; also elsewhere on the board
PWM_CH2_N: CN4.5 (B-), MOT_2.3; also elsewhere on the board
PWM_CH2_P: CN4.6 (B+), MOT_2.4; also elsewhere on the board

Notes on the sheet:
USCITA ALIMENTAZIONI
24V ENCODER
OpenCollector ENCODER

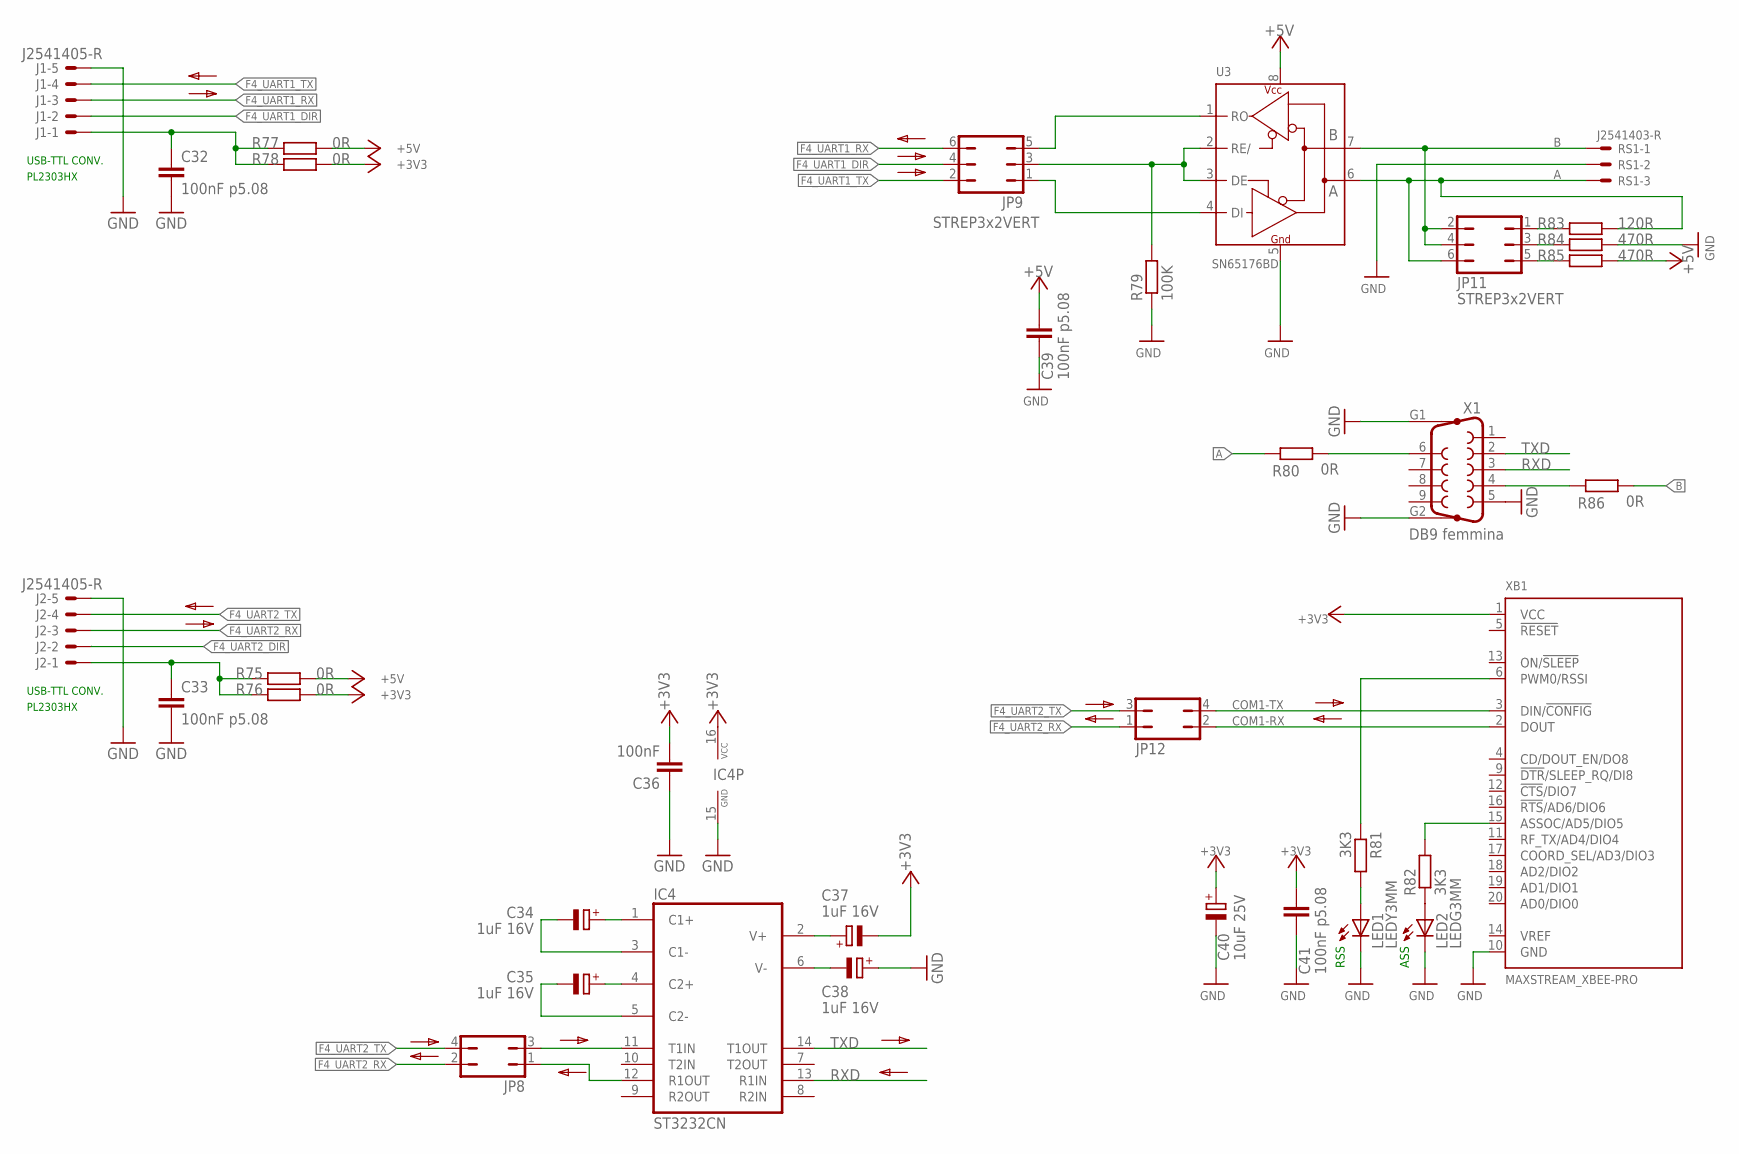
[picture p14: schematic RoboDiscovery-F4_V1.0.sch, sheet 6]

Parts:
C32, C33, C39, C41: 100nF p5.08; C050-024X044
C34, C35, C37, C38: 1uF 16V; E2,5-5
C36: 100nF; C025-025X050
C40: 10uF 25V; E2,5-5
IC4: ST3232CN; DIL16
J1, J2: J2541405-R; 6410-05
JP8, JP12: JP2Q
JP9, JP11: STREP3x2VERT; JP3Q
LED1: LEDY3MM; LED3MM
LED2: LEDG3MM; LED3MM
R75, R76, R77, R78, R80, R86: 0R; 0207/7
R79: 100K; 0207/7
R81, R82: 3K3; 0207/7
R83: 120R; 0207/7
R84, R85: 470R; 0207/7
RS1: J2541403-R; 6410-03
U3: SN65176BD; DIL8
X1: DB9 femmina; F09HP
XB1: MAXSTREAM_XBEE-PRO

Connections:
+3V3: C36.2, C37.-, C40.+, C41.1, IC4.16 (VCC), R76.1, R78.1, XB1.1 (VCC); also elsewhere on the board
+5V: C39.1, R75.1, R77.1, R85.1, U3.8 (VCC); also elsewhere on the board
A: JP11.6, R80.2, R83.1, RS1.3, U3.6 (A)
B: JP11.2, JP11.4, R86.1, RS1.1, U3.7 (B)
COM1-RX: JP12.2, XB1.2 (DOUT)
COM1-TX: JP12.4, XB1.3 (DIN/!CONFIG)
F4_UART1_DIR: J1.2, JP9.4; also elsewhere on the board
F4_UART1_RX: J1.3, JP9.6; also elsewhere on the board
F4_UART1_TX: J1.4, JP9.2; also elsewhere on the board
F4_UART2_DIR: J2.2; also elsewhere on the board
F4_UART2_RX: J2.3, JP8.2, JP12.1; also elsewhere on the board
F4_UART2_TX: J2.4, JP8.4, JP12.3; also elsewhere on the board
GND: C32.2, C33.2, C36.1, C38.+, C39.2, C40.-, C41.2, IC4.15 (GND), J1.5, J2.5, LED1.K (C), LED2.K (C), R79.1, R84.2, RS1.2, U3.5 (GND), X1.5, X1.G1, X1.G2, XB1.10 (GND); also elsewhere on the board
unnamed: C33.1, J2.1, R75.2, R76.2
unnamed: R82.2, XB1.15 (ASSOC/AD5/DIO5)
unnamed: LED2.A, R82.1
unnamed: LED1.A, R81.2
unnamed: R81.1, XB1.6 (PWM0/RSSI)
unnamed: R80.1, X1.6
unnamed: C32.1, J1.1, R77.2, R78.2
unnamed: JP11.3, R84.1
unnamed: JP11.5, R85.2
unnamed: JP11.1, R83.2
unnamed: C35.-, IC4.5 (C2-)
unnamed: C34.-, IC4.3 (C1-)
unnamed: C34.+, IC4.1 (C1+)
unnamed: C35.+, IC4.4 (C2+)
unnamed: C38.-, IC4.6 (V-)
unnamed: C37.+, IC4.2 (V+)
unnamed: IC4.11 (T1IN), JP8.3
unnamed: IC4.12 (R1OUT), JP8.1
unnamed: JP9.5, U3.1 (RO)
unnamed: R86.2, X1.4
RS-DIR: JP9.3, R79.2, U3.2 (RE/), U3.3 (DE)
RS-TX: JP9.1, U3.4 (DI)
RXD: IC4.13 (R1IN), X1.3
TXD: IC4.14 (T1OUT), X1.2

Notes on the sheet:
USB-TTL CONV.
PL2303HX
RSS
ASS
