Myzhar/RoboDiscovery-F4/Board/RoboDiscovery-F4_v1.0/RoboDiscovery-F4_V1.0.brd

## EAGLE design Board/RoboDiscovery-F4_v1.0/RoboDiscovery-F4_V1.0.brd (continued)

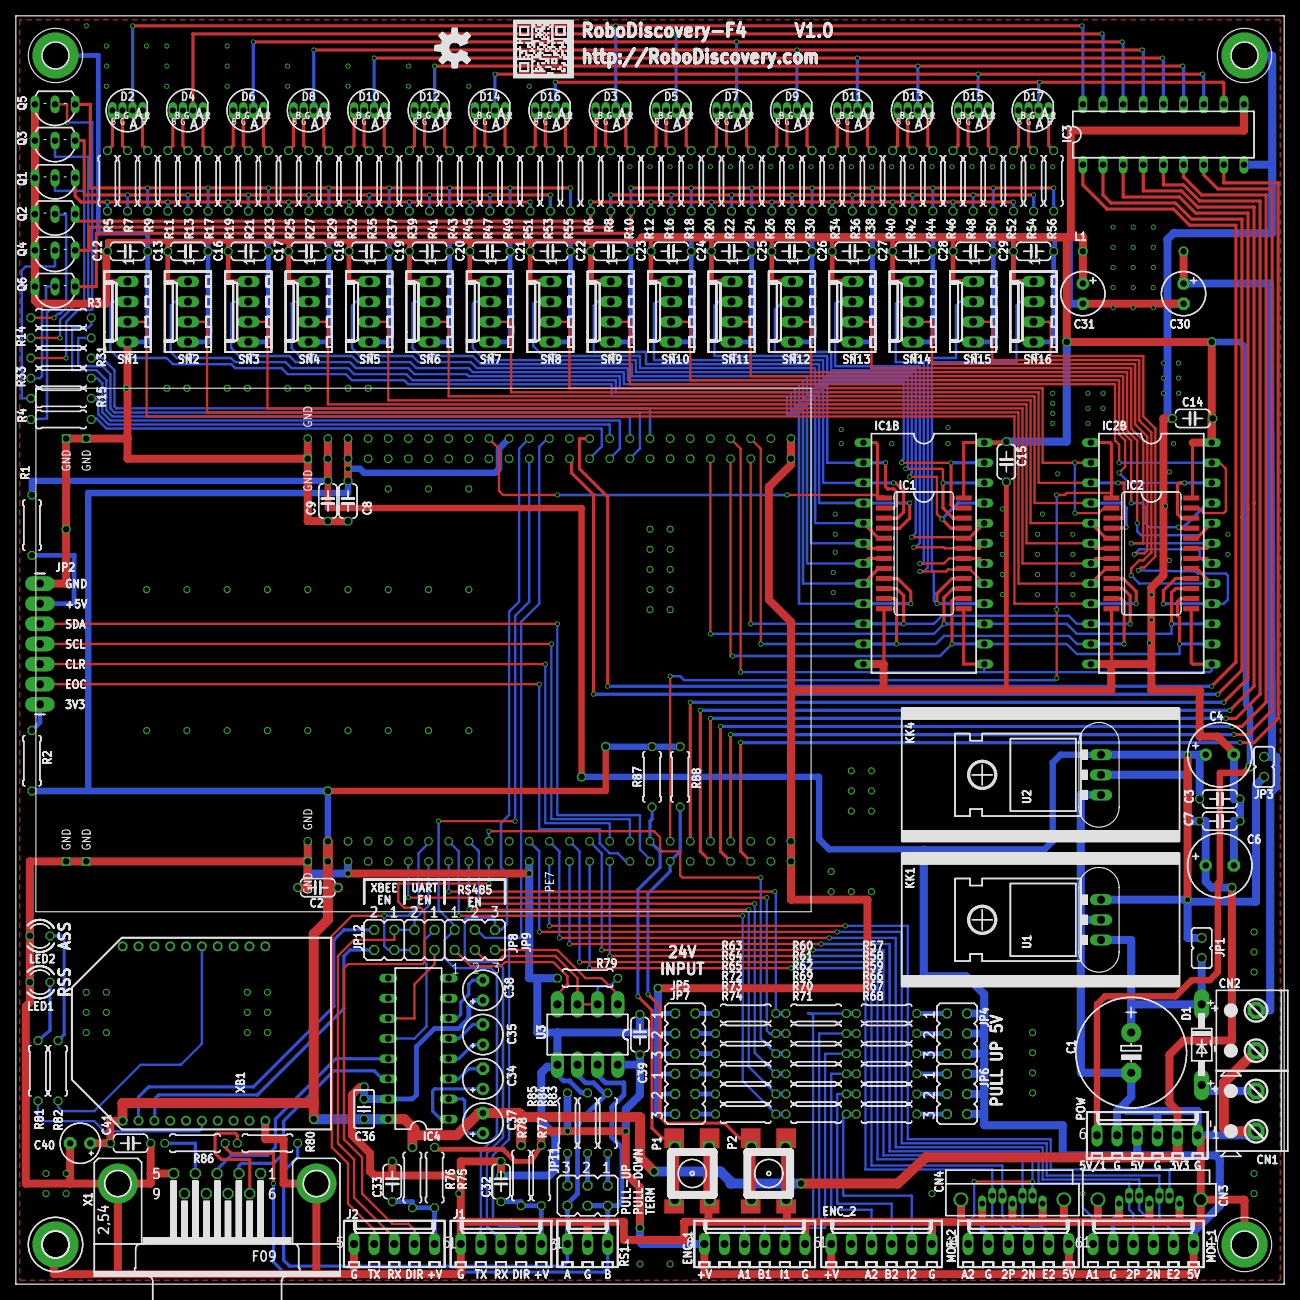
[picture p15: board RoboDiscovery-F4_V1.0.brd from above]

Board: 2 copper layers, 160.0 x 160.0 mm, 212 parts (0 on the bottom side), 202 nets.
