Myzhar/RoboDiscovery-F4/Firmware/Sonar-Module.ioc

Mcu.UserName=STM32F407VGTx
PA0-WKUP.GPIO_Label=USER_BUT
PA0-WKUP.Signal=GPIO_Input
PA1.GPIO_Label=ENC1_B
PA1.Signal=S_TIM2_CH2
PA10.GPIO_Label=MUX_INH
PA10.Signal=GPIO_Output
PA11.Signal=USB_OTG_FS_DM
PA12.Signal=USB_OTG_FS_DP
PA13.Signal=SYS_JTMS-SWDIO
PA14.Signal=SYS_JTCK-SWCLK
PA2.GPIO_Label=F4_UART2_TX
PA2.Signal=USART2_TX
PA3.GPIO_Label=F4_UART2_RX
PA3.Signal=USART2_RX
PA4.GPIO_Label=ENC2_IDX
PA4.Signal=GPIO_Input
PA5.GPIO_Label=ENC1_A
PA5.Signal=S_TIM2_CH1_ETR
PA6.GPIO_Label=ENC2_A
PA6.Signal=S_TIM3_CH1
PA7.GPIO_Label=ENC2_B
PA7.Signal=S_TIM3_CH2
PA8.GPIO_Label=MUX_C
PA8.Signal=GPIO_Output
PA9.GPIO_Label=MUX_D
PA9.Signal=GPIO_Output
PB10.GPIO_Label=BMP085_SCL
PB10.Signal=I2C2_SCL
PB11.GPIO_Label=BMP085_SDA
PB11.Signal=I2C2_SDA
PB12.GPIO_Label=P1
PB12.Signal=GPIO_Input
PB13.GPIO_Label=P2
PB13.Signal=GPIO_Input
PB14.GPIO_Label=ECHO_MUX
PB14.Signal=S_TIM12_CH1
PB2.GPIO_Label=MOTOR1_EN
PB2.Signal=GPIO_Output
PB3.Signal=SYS_JTDO-SWO
PB5.GPIO_Label=F4_UART1_DIR
PB5.Signal=GPIO_Output
PB6.GPIO_Label=F4_UART1_TX
PB6.Signal=USART1_TX
PB7.GPIO_Label=F4_UART1_RX
PB7.Signal=USART1_RX
PB8.GPIO_Label=TR_S2_GREEN
PB8.Signal=GPIO_Output
PB9.GPIO_Label=TRIGGER_MUX
PB9.Signal=S_TIM11_CH1
PC4.GPIO_Label=ENC1_IDX
PC4.Signal=GPIO_Input
PC5.GPIO_Label=F4_UART2_DIR
PC5.Signal=GPIO_Output
PC8.GPIO_Label=MUX_A
PC8.Signal=GPIO_Output
PC9.GPIO_Label=MUX_B
PC9.Signal=GPIO_Output
PD0.GPIO_Label=TR_S1_RED
PD0.Signal=GPIO_Output
PD1.GPIO_Label=TR_S1_GREEN
PD1.Signal=GPIO_Output
PD10.GPIO_Label=KLED_5
PD10.Signal=GPIO_Output
PD11.GPIO_Label=KLED_6
PD11.Signal=GPIO_Output
PD12.GPIO_Label=KLED_7-Disc_Green
PD12.Signal=GPIO_Output
PD13.GPIO_Label=KLED_8-Disc_Orange
PD13.Signal=GPIO_Output
PD14.GPIO_Label=Disc_Red
PD14.Signal=GPIO_Output
PD15.GPIO_Label=Disc_Blue
PD15.Signal=GPIO_Output
PD2.GPIO_Label=TR_S1_BLUE
PD2.Signal=GPIO_Output
PD3.GPIO_Label=TR_S2_RED
PD3.Signal=GPIO_Output
PD5.GPIO_Label=TR_S2_BLUE
PD5.Signal=GPIO_Output
PD6.GPIO_Label=KLED_1
PD6.Signal=GPIO_Output
PD7.GPIO_Label=KLED_2
PD7.Signal=GPIO_Output
PD8.GPIO_Label=KLED_3
PD8.Signal=GPIO_Output
PD9.GPIO_Label=KLED_4
PD9.Signal=GPIO_Output
PE10.GPIO_Label=PWM_CH2_N
PE10.Signal=TIM1_CH2N
PE11.GPIO_Label=PWM_CH2_P
PE11.Signal=S_TIM1_CH2
PE12.GPIO_Label=MOTOR2_AUX
PE12.Signal=GPIO_Output
PE13.GPIO_Label=MOTOR2_EN
PE13.Signal=GPIO_Output
PE14.GPIO_Label=BMP085_CLR
PE14.Signal=GPIO_Output
PE15.GPIO_Label=BMP085_EOC
PE15.Signal=GPIO_Input
PE7.GPIO_Label=MOTOR1_AUX
PE7.Signal=GPIO_Output
PE8.GPIO_Label=PWM_CH1_M
PE8.Signal=TIM1_CH1N
PE9.GPIO_Label=PWM_CH1_P
PE9.Signal=S_TIM1_CH1
PH0-OSC_IN.Signal=RCC_OSC_IN
PH1-OSC_OUT.Signal=RCC_OSC_OUT
