Myzhar/RoboDiscovery-F4/Firmware/Src/tim_handler.c

#include "tim_handler.h"
#include "leds_handler.h"
#include "sonar_handler.h"

// Callback for Timer timeout
void HAL_TIM_PeriodElapsedCallback(TIM_HandleTypeDef *htim)
{
	if(htim->Instance==TIM7)
	{
		on_RGB_led_timer_timeout();
	}
}

// Callback for sonar impulse
void HAL_TIM_IC_CaptureCallback(TIM_HandleTypeDef *htim)
{
	if( htim == getSonarEchoTIM() )
		onNewMeasureReceived();
}
