Myzhar/RoboDiscovery-F4/Firmware/Inc/button_handler.h

#ifndef _BUTTON_HANDLER_H_
#define _BUTTON_HANDLER_H_
#include "gpio.h"

#define BUT_PRESSED 	0
#define BUT_RELEASED 	1

uint8_t getButtonDiscState(void);
uint8_t getButton1State(void);
uint8_t getButton2State(void);

#endif
