Myzhar/RoboDiscovery-F4/(commit log)

2014-06-24 Added project files from "Robocontroller" project
    [RoboDiscovery-F4_V1.0.brd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]
2014-06-28 First test on Firmware
    / This release of the FW tests the leds
2014-06-29 Test FW corrected
    / Corrected GPIO configuration to drive RGB LEds
    [Sonar-Module.ioc, dma.h, gpio.h, i2c.h, main.c]
2014-07-19 Updated RGB Leds handling
2014-08-22 New led handler
    / Added new led handler based on TIM7
2014-08-28 First test on Sonar
    / TODO add "sonar_handler.h/.c"
2014-09-15 Sonar Handling
